requireiot/MyDashboard/hardware/Power consumption.xlsx

ESP8266, TFT, on-demand
State | Duration [µs] | Duration [ms] | Current [mA] | Current [µA] | repeat /day | total time [s] | total [mAh] | I avg [mA]
Active, Wifi on, refresh display |  | 2000 | 250 |  | 2 | 4 | 0.28 | 0.01157407407
Active, TFT on |  | 5000 | 85 |  | 2 | 10 | 0.24 | 0.009837962963
sleep |  |  |  | 0 |  | 86386 | 0.00 | 0.000
self discharge |  |  |  | 35 |  | 86400 | 0.84
 |  |  |  |  |  |  | 1.35 | mAh / day
 |  |  |  |  |  |  | 1250 | mAh AAA battery
 |  |  |  |  |  |  | 75% | of capacity is usable
 |  |  |  |  |  |  | 692.4497333 | days
 |  |  |  |  |  |  | 1.9 | years
e-Ink, NRF24, AVR
State | Duration [µs] | Duration [ms] | Current [mA] | Current [µA] | repeat /day | total time [s] | total [mAh] | I avg [mA]
Active, NRF on, refresh display |  | 100 | 20 |  | 24 | 2.4 | 0.01 | 0.0005555555556
Active, wait for ePaper not busy |  | 17000 | 5 |  | 24 | 408 | 0.57 | 0.02361111111
sleep |  |  |  | 50 |  | 85989.6 | 1.19 | 0.000 | is 0.9µA AVR, 0.9µA NRF
self discharge |  |  |  | 80 |  | 86400 | 1.92
 |  |  |  |  |  |  | 3.69 | mAh / day
 |  |  |  |  |  |  | 2800 | mAh AA battery
 |  |  |  |  |  |  | 75% | of capacity is usable
 |  |  |  |  |  |  | 568.4432775 | days
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
