requireiot/MyDashboard/hardware/BOM MyDashboard-eInk.xlsx

Item | qty | lot size | €/lot | €/pc | cost | vendor | part #
2.9" ePaper Module | 1 | 1 | 13.57 € | 13.57 € | 13.57 € | Aliexpress
ESP-12F | 1 | 1 | 1.17 € | 1.17 € | 1.17 € | Aliexpress
Prototype PCB for ESP8266 | 1 | 1 | 0.63 € | 0.63 € | 0.63 € | Aliexpress | 5x7CM Double Side Prototype PCB Board Breadboard Protoshield For Arduino Relay ESP8266 WIFI ESP-12F ESP-12E ESP32 ESP32S
ABS case KEMO G081N | 1 | 1 | 3.70 € | 3.70 € | 3.70 € | Pollin | 460637
2x AA battery holder | 1 | 10 | 1.22 € | 0.12 € | 0.12 € | Aliexpress | 10PCS Plastic Battery Case Storage Box Holder with Wire Leads for 2 X 1X AA 3.0V 2AA
Proto board 4x6cm | 1 | 10 | 4.50 € | 0.45 € | 0.45 € | Aliexpress | 5PCS Electronic PCB Board 4x6cm Diy Blue PCB
1N5817 Schottky diode | 3 | 100 | 1.52 € | 0.02 € | 0.05 € | Aliexpress
1000 uF | 1 | 1 | 0.22 € | 0.22 € | 0.22 € | Reichelt | M-A 1,0M 16
 |  |  |  |  | 19.91 €
