requireiot/MyDashboard/hardware/MyDashboard-epaper.pdf

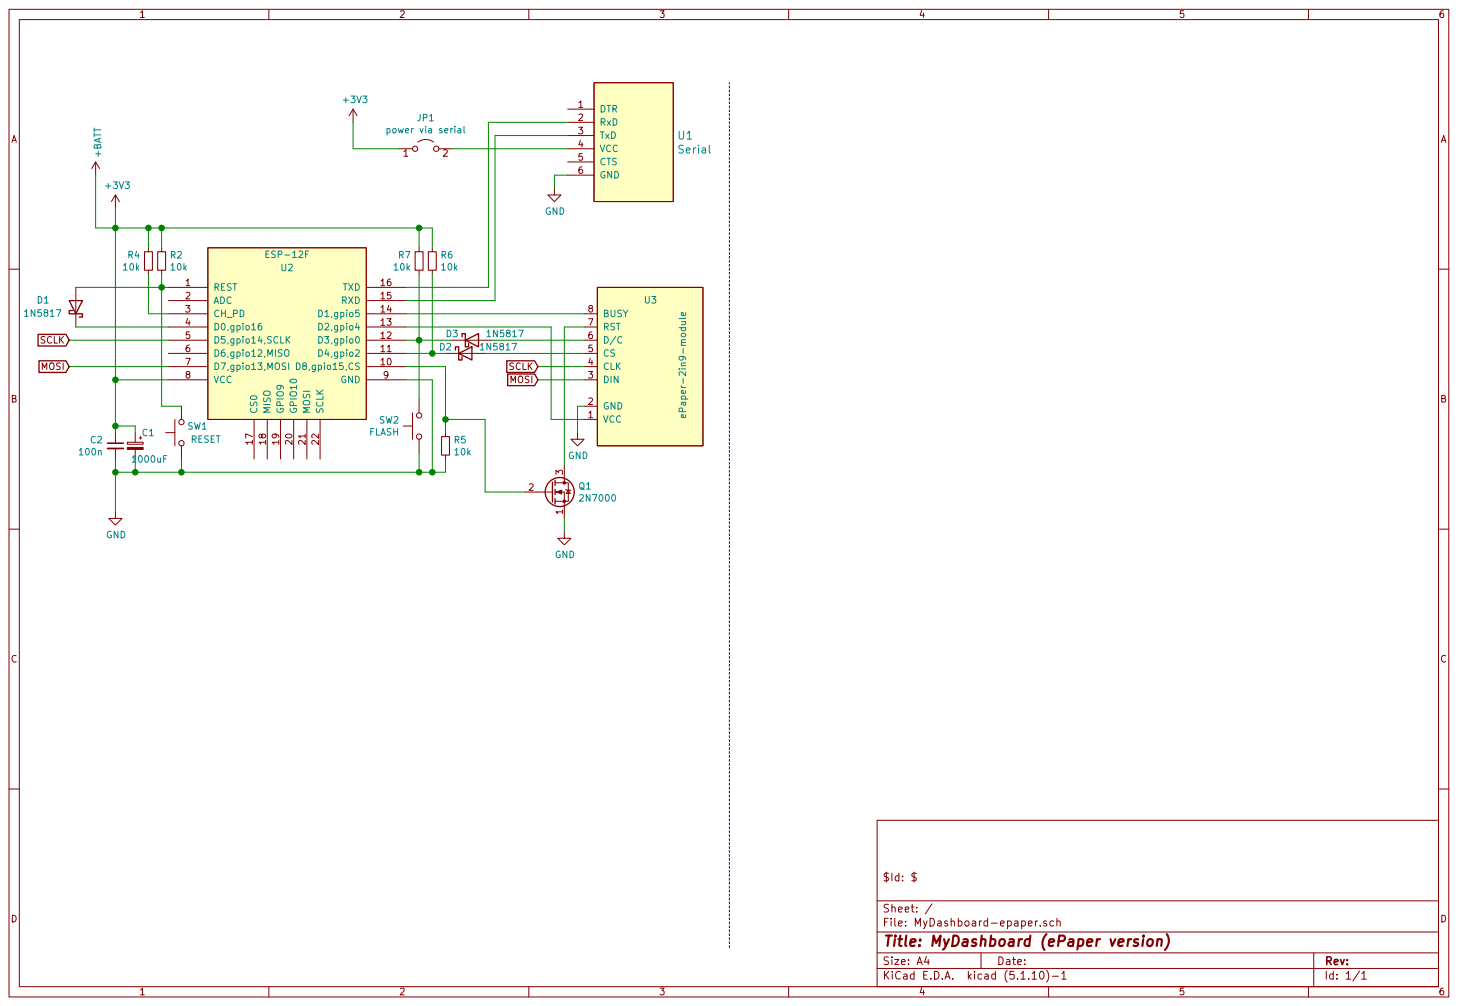
[picture p4: page 1]

File: MyDashboard-epaper.sch Sheet: / $Id: $

Id: 1/1 Title: MyDashboard (ePaper version)
