requireiot/MyDashboard/src/myauth_sample.h

#ifndef __MYAUTH_H
#define __MYAUTH_H

// fill in your real Wifi information and save as "myauth.h"

const char* WIFI_SSID       = "my-wifi-ssid";
const char* WIFI_PASSWORD   = "my-secret-wifi-password";

#endif // __MYAUTH_H
